Bastouil/Porjet_CAO_PEI2/assemblage.SLDASM

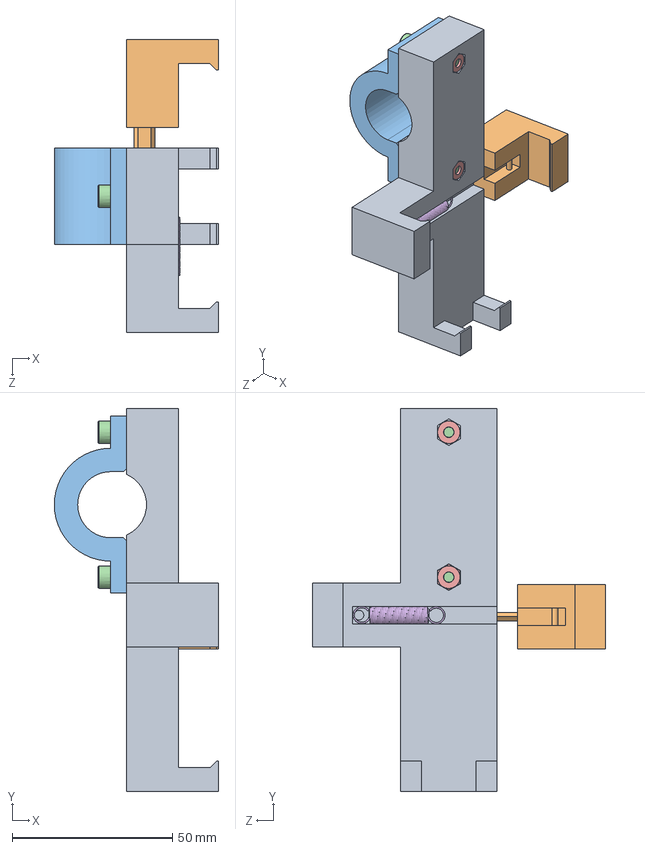
[picture p7: CAD file, 2023-02-08]
assemblage.SLDASM
51.3 x 119.4 x 91.4 mm
supportPrincipal
bras_mobile
attache
Vis à tête cylindrique à six pans creux Chc M4 - 20 x 2
Ecrou M4 x 2
Ressort
