Bastouil/Porjet_CAO_PEI2/assemblage_avec_smartphone.SLDASM

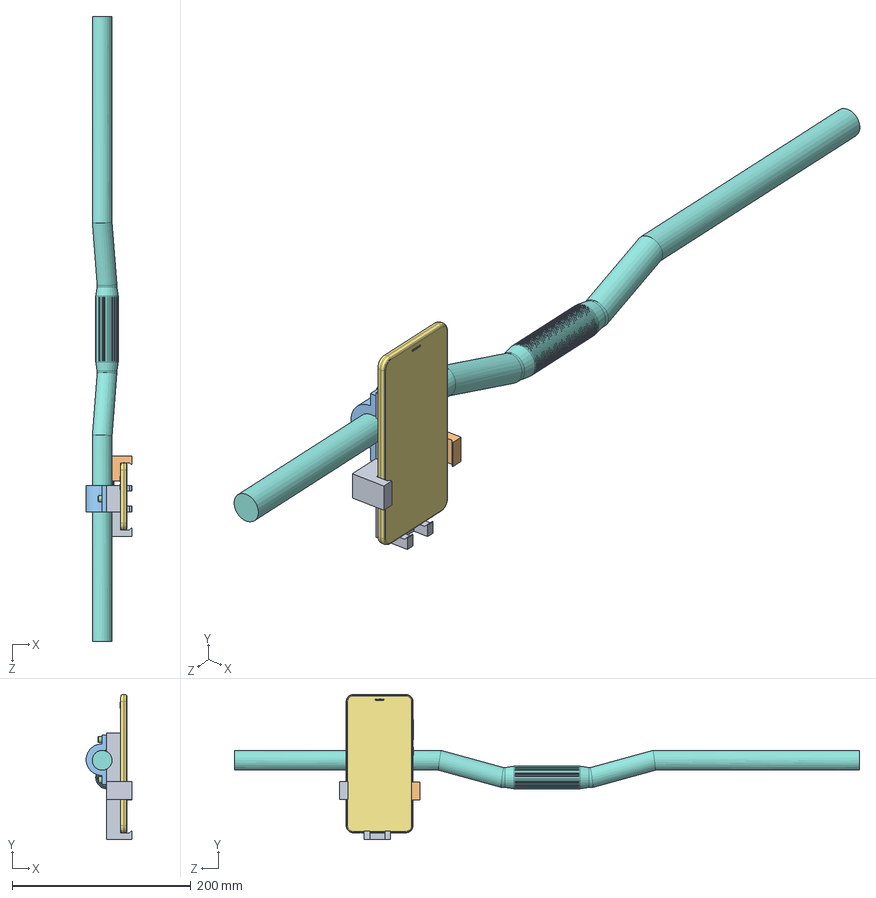
[picture p8: CAD file, 2023-02-08]
assemblage_avec_smartphone.SLDASM
51.3 x 162.5 x 700.0 mm
supportPrincipal
bras_mobile
attache
Vis à tête cylindrique à six pans creux Chc M4 - 20 x 2
Ecrou M4 x 2
Ressort
smartphone
cintre
