Bastouil/Porjet_CAO_PEI2/cintre.SLDPRT

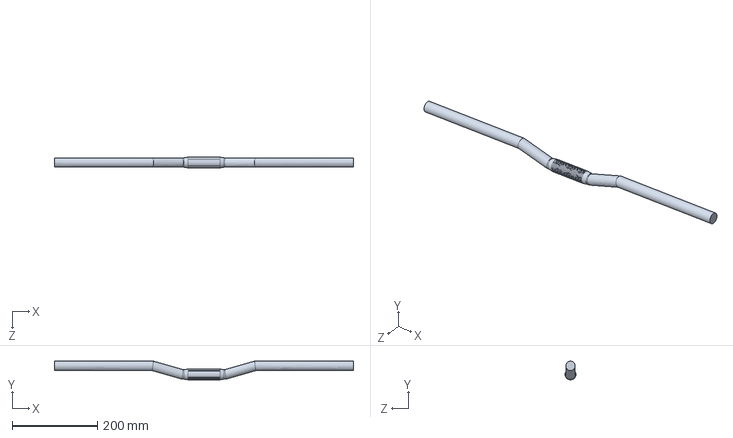
[picture p9: CAD file, 2023-02-08]
cintre.SLDPRT
700.0 x 43.8 x 25.4 mm
