Bastouil/Porjet_CAO_PEI2/attache.SLDPRT

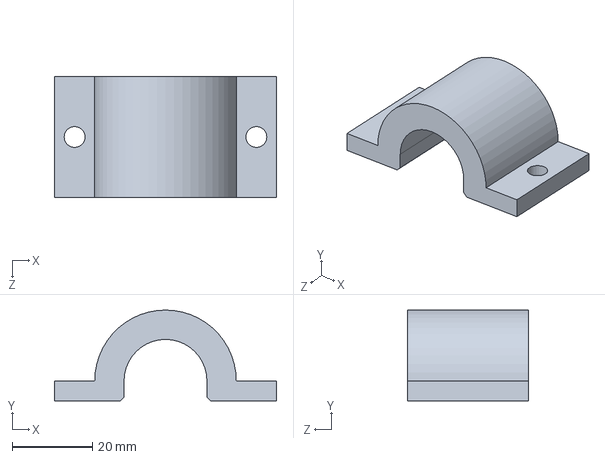
[picture p10: CAD file, 2023-02-08]
attache.SLDPRT
55.2 x 22.6 x 30.0 mm
