Bastouil/Porjet_CAO_PEI2/Ecrou M4.SLDPRT

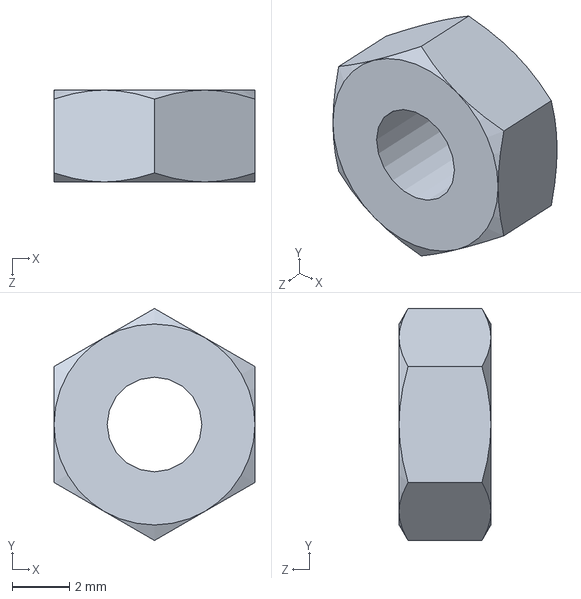
[picture p11: CAD file, 2023-02-08]
Ecrou M4.SLDPRT
7.00 x 8.08 x 3.20 mm
