Bastouil/Porjet_CAO_PEI2/smartphone.SLDPRT

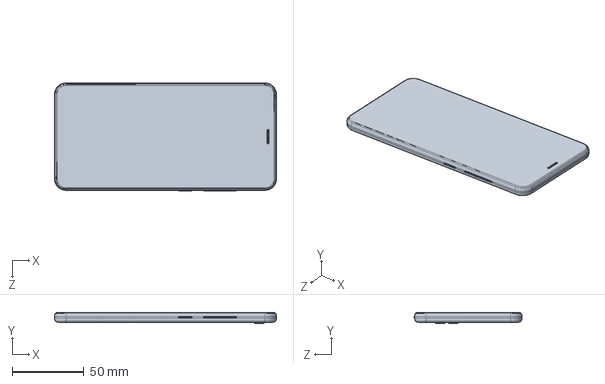
[picture p12: CAD file, 2023-02-08]
smartphone.SLDPRT
155.0 x 8.00 x 75.5 mm
