Bastouil/Porjet_CAO_PEI2/supportPrincipal.SLDPRT

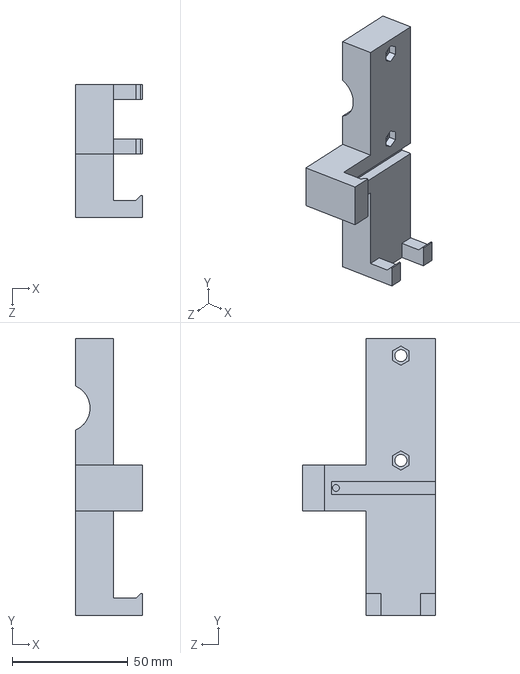
[picture p13: CAD file, 2023-02-08]
supportPrincipal.SLDPRT
28.7 x 119.4 x 57.5 mm
