Bastouil/Porjet_CAO_PEI2/bras_mobile.SLDPRT

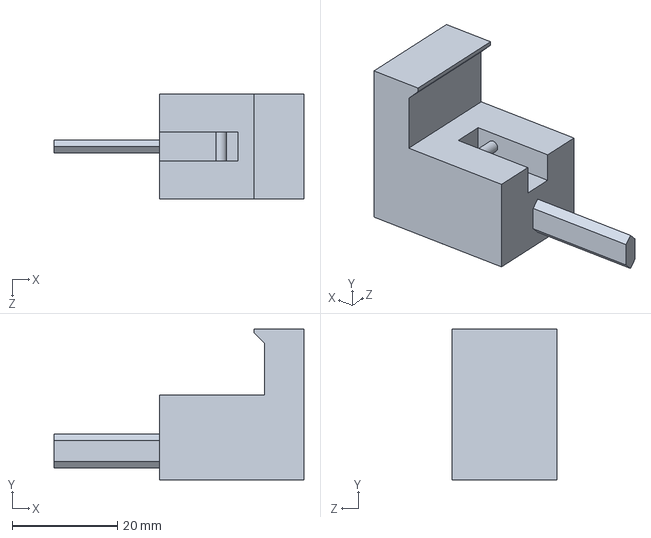
[picture p14: CAD file, 2023-02-08]
bras_mobile.SLDPRT
47.5 x 28.7 x 20.0 mm
