Bastouil/Porjet_CAO_PEI2/Ressort.SLDPRT

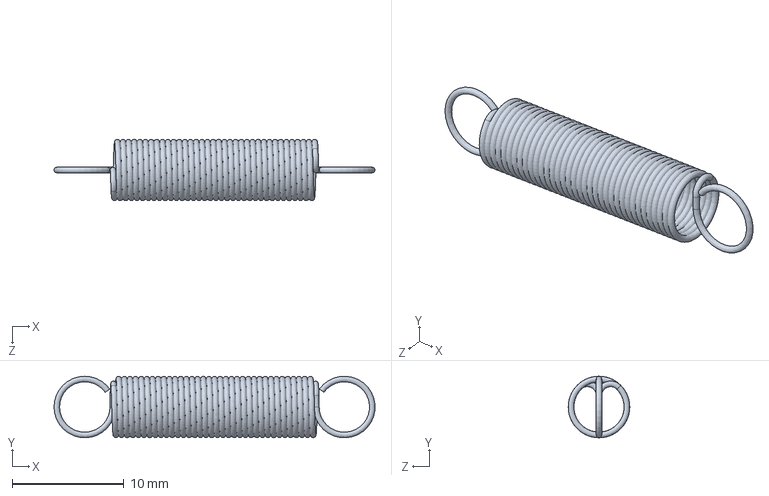
[picture p15: CAD file, 2023-02-08]
Ressort.SLDPRT
28.7 x 5.50 x 5.50 mm
