Bastouil/Porjet_CAO_PEI2/Vis à tête cylindrique à six pans creux Chc M4 - 20.SLDPRT

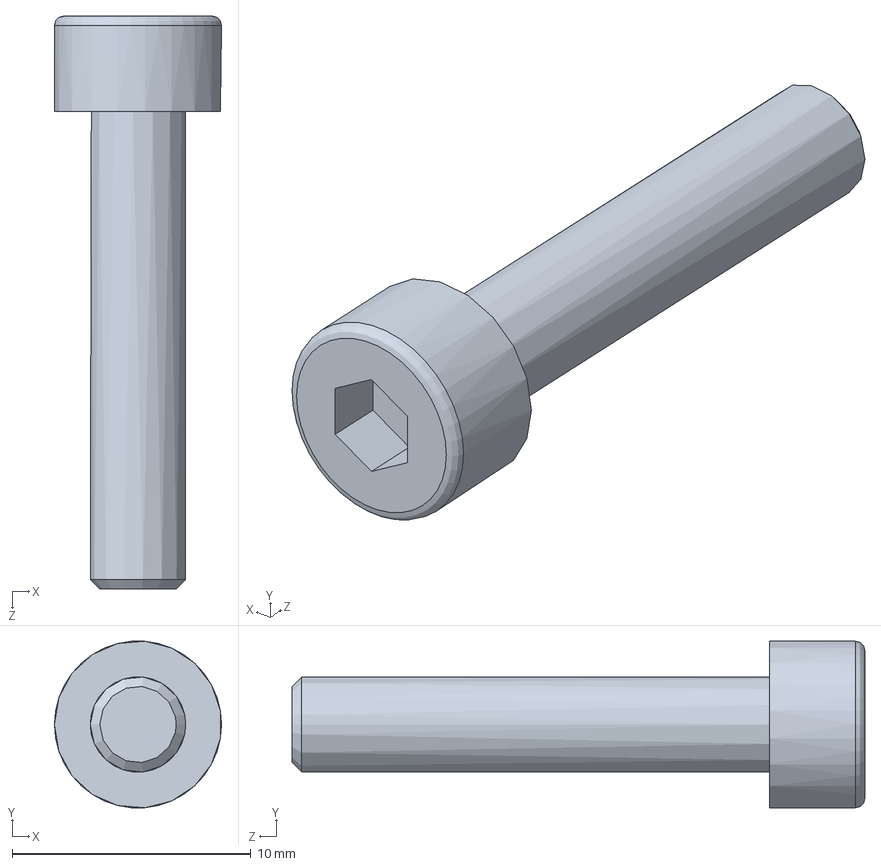
[picture p16: CAD file, 2023-02-08]
Vis à tête cylindrique à six pans creux Chc M4 - 20.SLDPRT
7.00 x 6.98 x 24.0 mm
