Bastouil/Porjet_CAO_PEI2/(list of files, cad)

Other CAD files:
attache.SLDDRW
bras_mobile.SLDDRW
supportPrincipal.SLDDRW
